nub340/Tesla-Front-Drive-Unit/tesla_sdu_controller_connections.png

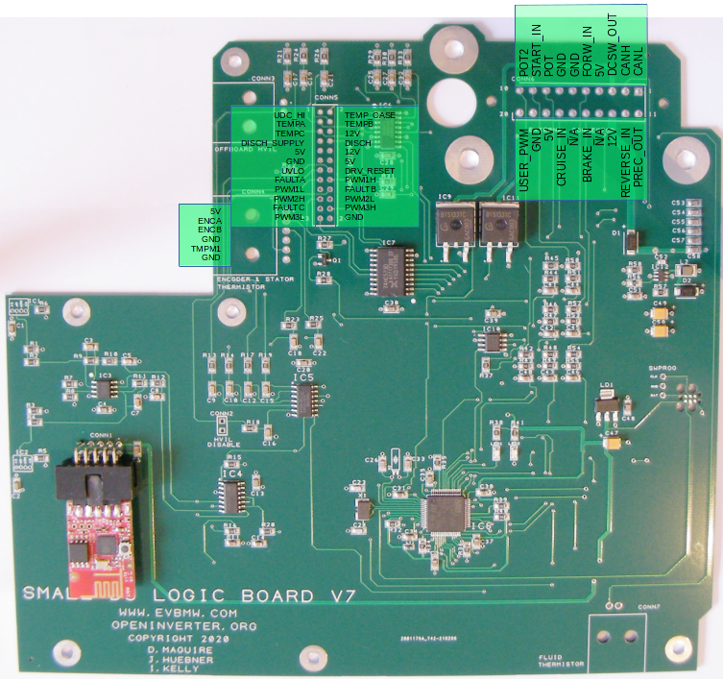
tesla_sdu_controller_connections.png
