nub340/Tesla-Front-Drive-Unit/V7/Tesla_FDU_V7_BOM_JLC_2.xls

Comment | Designator | Footprint | LCSC Part #
74HCT4052D | IC6 | SOIC-16_3.9x9.9x1.27P | C87281
BTS133TC | IC9,IC11 | TO-263-2 | C2681318 | C152447
0.1uF | C1,C2,C4,C13,C20,C28,C30,C35,C39,C53,C52 | 0805_C | C49678
1nF | C5,C8,C18,C22,C29 | 0805_C | C46653
1uF | C11,C14,C17,C19,C21,C25,C27,C31,C32,C36,C37,C38,C40,C41,C42,C43,C44,C45,C46,C51 | 0805_C | C28323
10nF | C9,C10,C12,C15,C16, | 0805_C | C1710
22PF | C23,C24 | 0805_C | C1804
50pF | C3,C7 | 0805_C | C1716
CD74HC30M | IC5 | SOIC-14_3.9x8.7x1.27P | C6540
10pF | C26,C33 | C_0805 | C1785
10uF | C6,C34,C48,C54,C55,C56,C57,C58 | 0805_C | C40894
AMS1117-3.3 | LD1 | SOT-223 | C6186
RED LEDS | LED1,LED2 | CHIPLED_0805 | C84256
SCT2401TVBR | IC12 | TSOT-23-6 | C2830166
LM2901DT | IC4 | SOIC-14_3.9x8.7x1.27P | C142961
10uH | L1 | 0603 | C1035
MC74HCT573ADWR2G | IC7 | SOIC-20_7.5x12.8x1.27P | C5608
LM2904DR2G | IC3 | SOIC-8_3.9x4.9x1.27P | C18229
MMBT3904 | Q1 | SOT-23-3 | C20526
1KΩ | R23,R28,R32,R34,R38,R39,R40 | 0805_R | C17513
1.5KΩ | R43,R47,R49,R53,R55 | 0805_R | C4310
3.3KΩ | R10,R12,R31 | 0805_R | C26010
3.16KΩ | R7 | 0805_R | C52603
4.7KΩ | R8,R36,R42,R46,R48,R52,R54 | 0805_R | C23162
10KΩ | R1,R3,R5,R6,R15,R16,R20,R22,R25,R35,R44,R45,R50,R51,R58 | 0805_R | C17414
62KΩ | R9,R11 | 0805_R | C17783
100KΩ | R2,R4,R57 | 0603_R | C25803
100Ω | R27 | 0805_R | C17408
120Ω | R37 | 0805_R | C17437
150kΩ | R21,R24,R26,R30,R33 | 0805_R | C17470
470Ω | R41 | 0805_R | C17710
470kΩ | R29 | 0805_R | C17709
560Ω | R13,R14,R17,R18,R19 | 0805_R | C28636
SN65HVD230 | IC10 | SOIC-8_3.9x4.9x1.27P | C12084
SS54 | D1,D2 | SMA,DO-214AC | C22452
STM32F103RBT6 | IC8 | LQFP-64_10.0x10.0x0.5P | C8735
4.7UH | L2 | 1210 | C90319
100UF 6.3V | C50,C49,C47 | CASE-B_3528 | C16133
8MHz | X1 | SMD-5032_2P | C115962
51kΩ | R56 | 0805_R | C23196
