nub340/Tesla-Front-Drive-Unit/V9/Tesla_FDU_V9 - Schematic.pdf

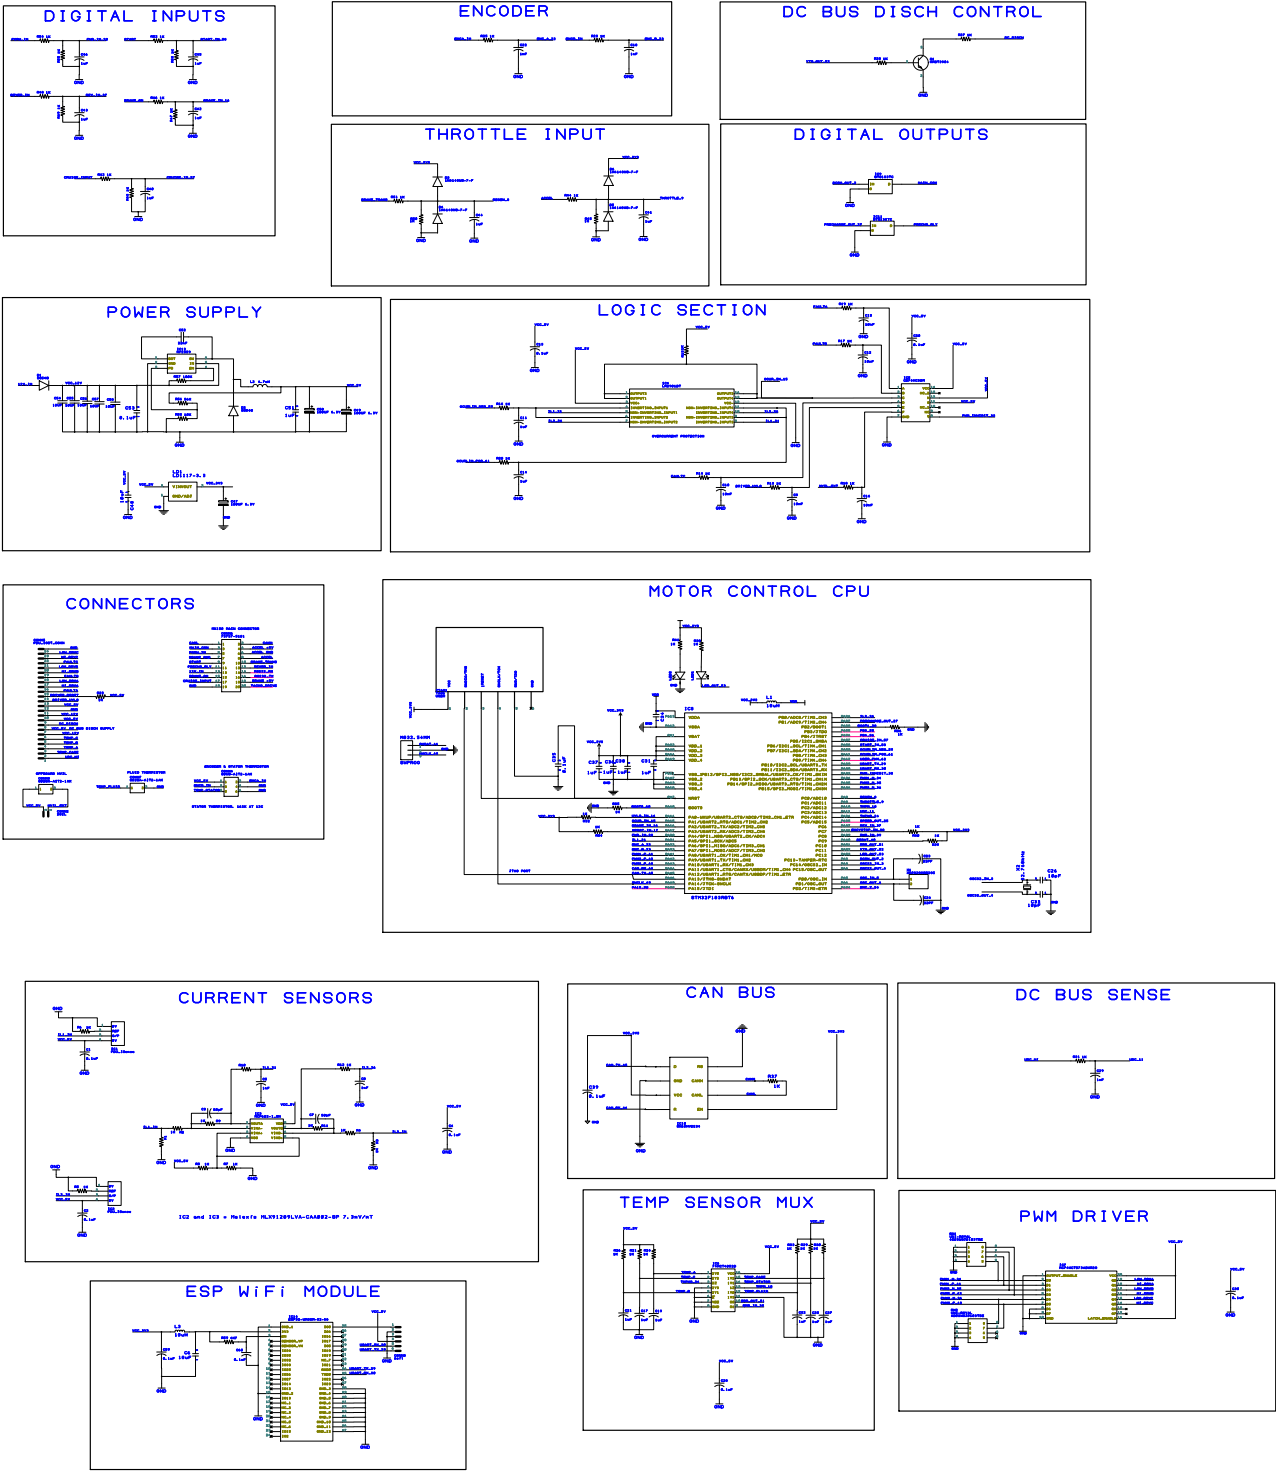
[picture p2: page 1]
