nub340/Tesla-Front-Drive-Unit/V9/Tesla_FDU_V9 - PCB.pdf

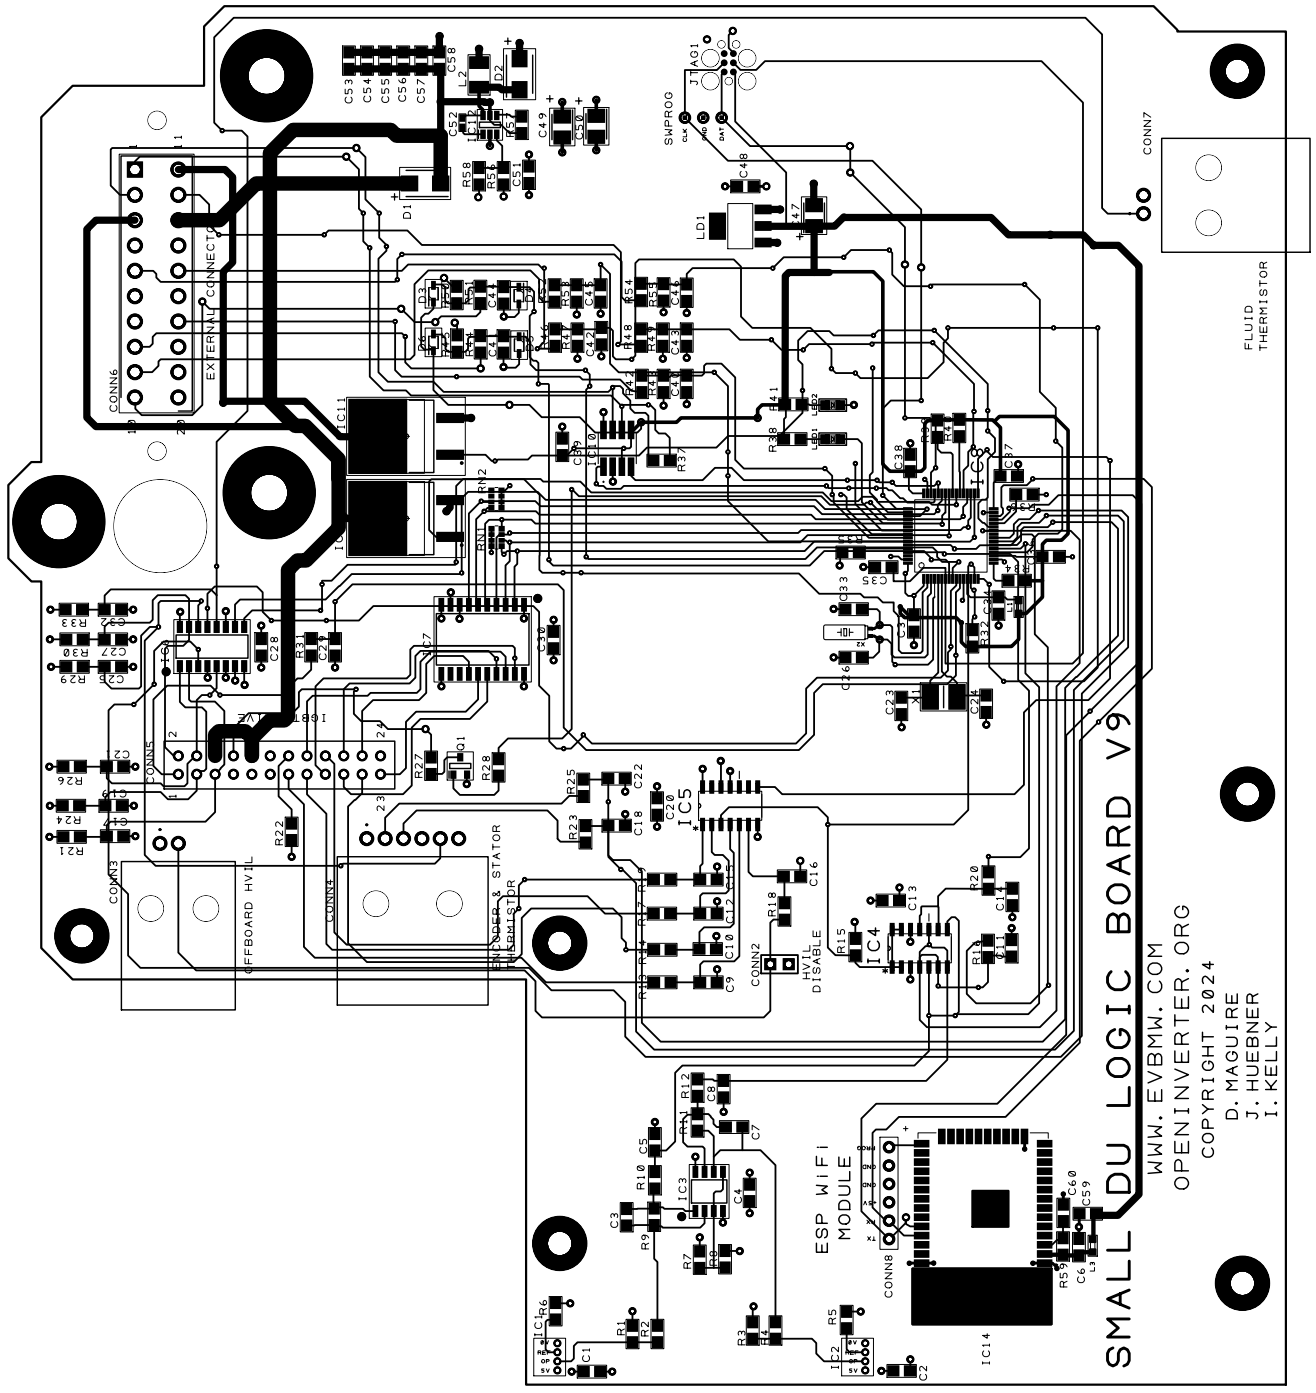
[picture p3: page 1]
