nub340/Tesla-Front-Drive-Unit/V8/Tesla_FDU_V8 - Schematic.pdf

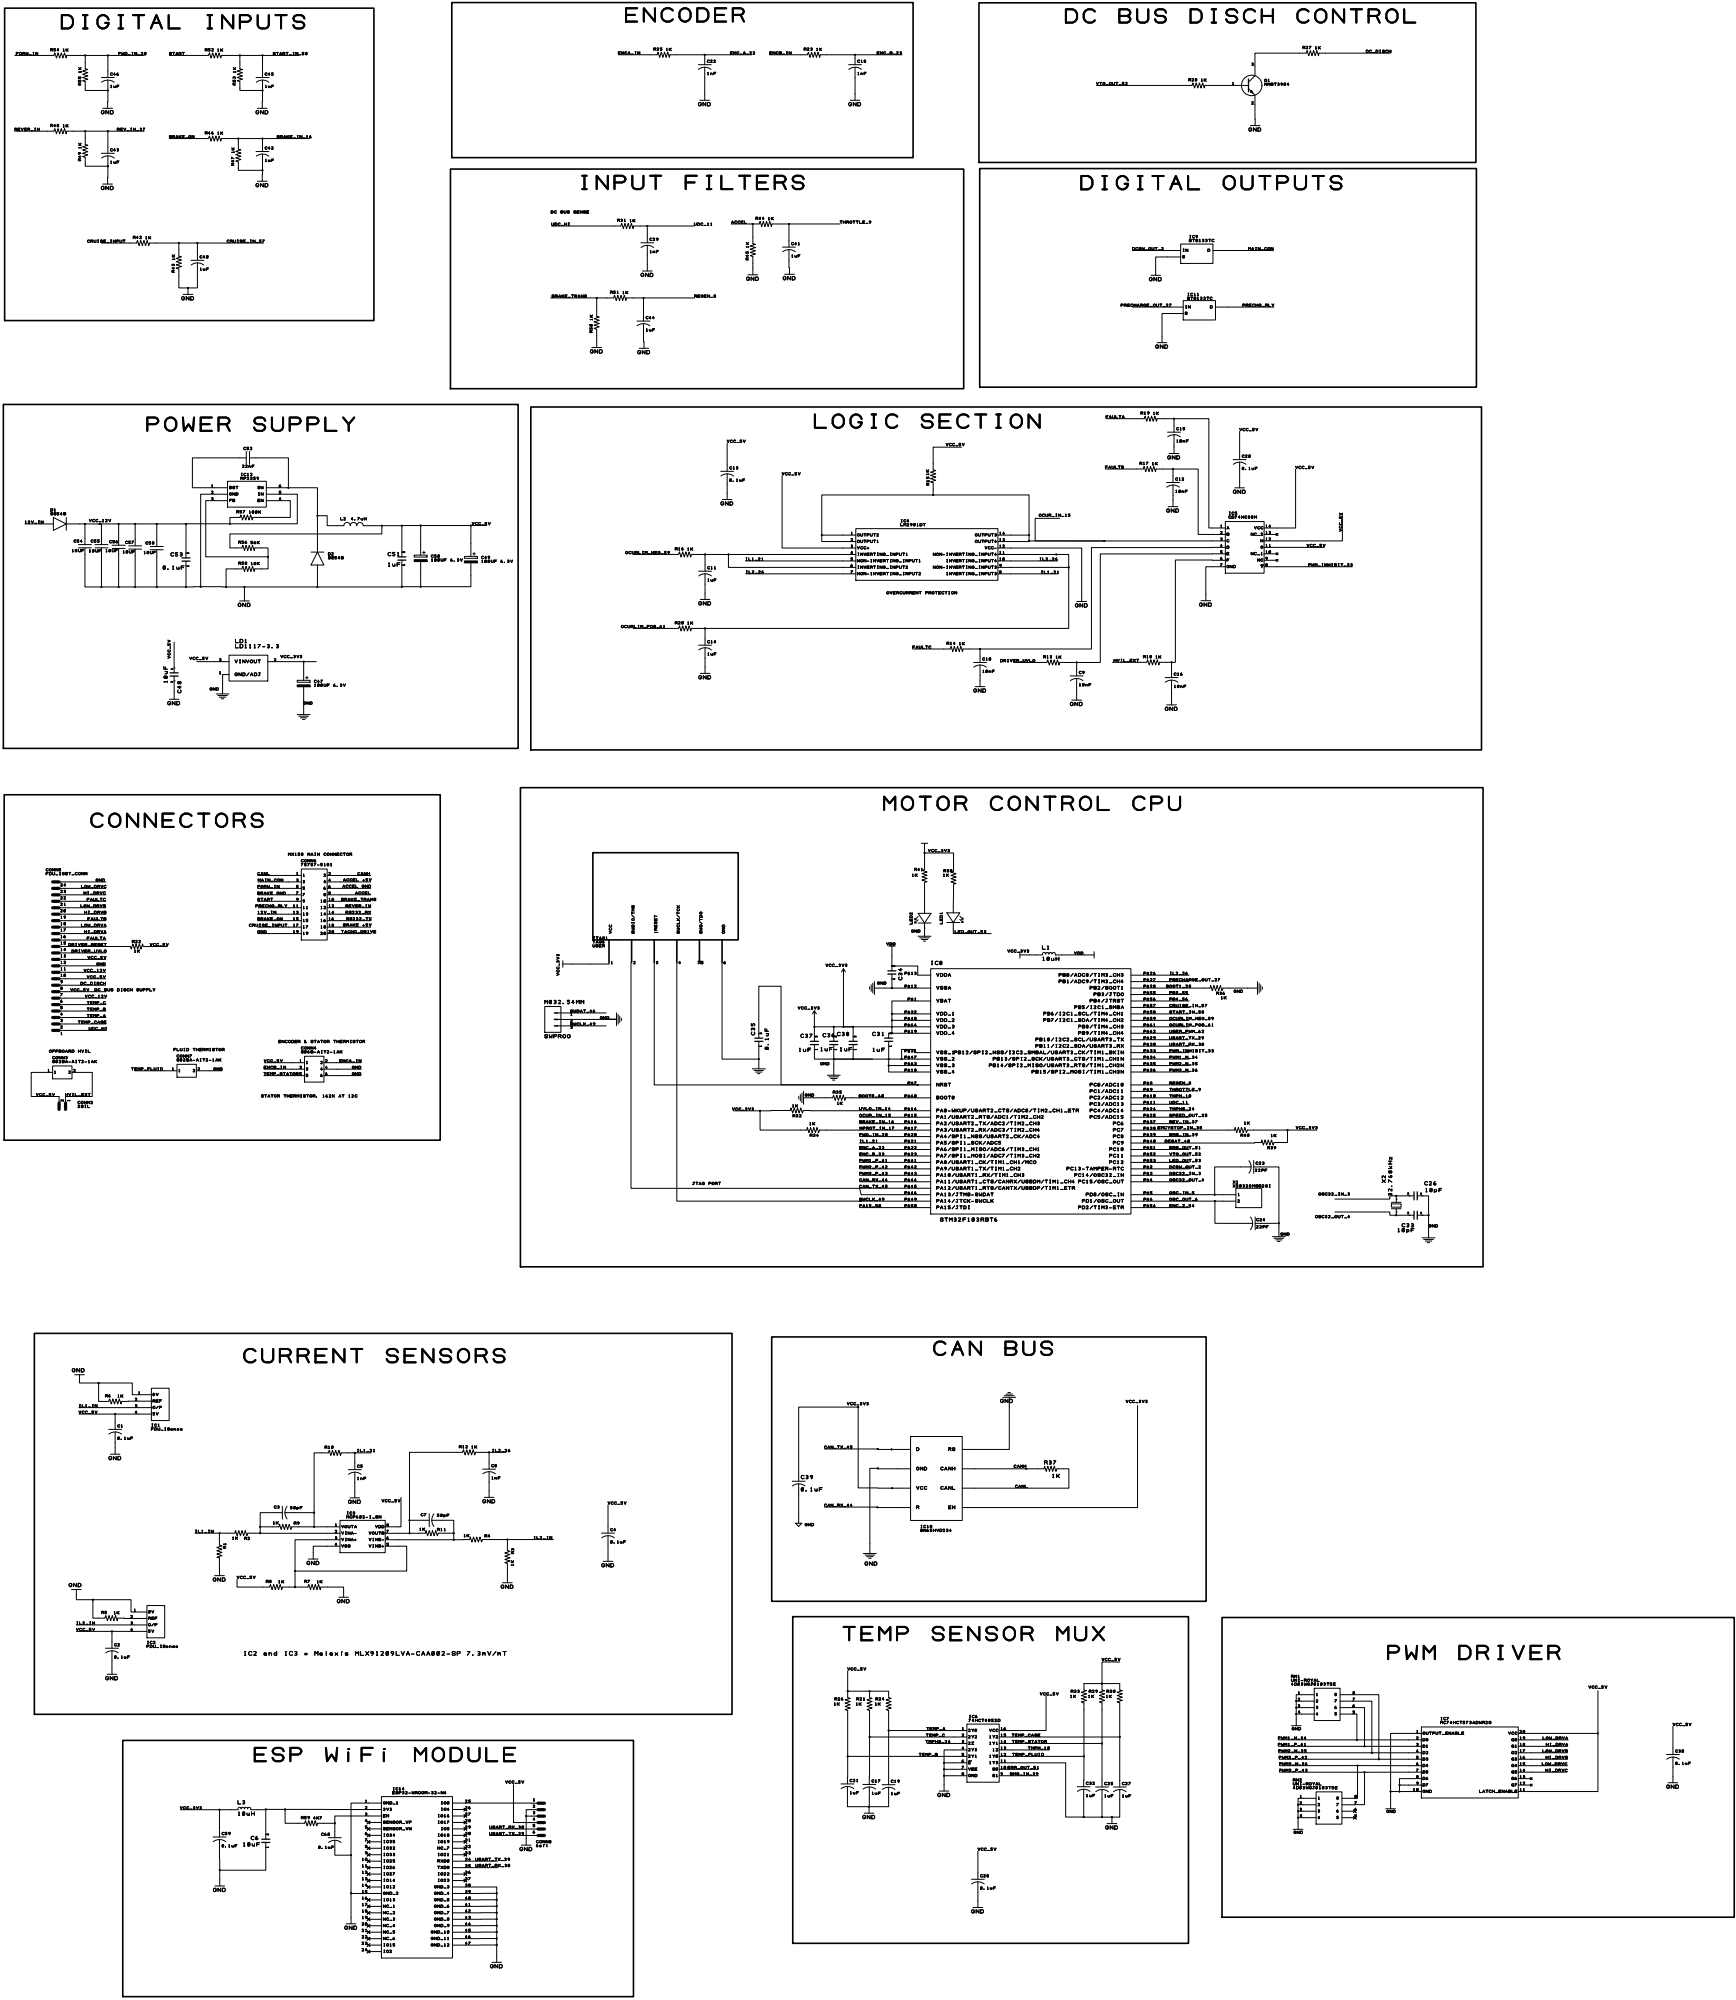
[picture p4: page 1]
