nub340/Tesla-Front-Drive-Unit/(list of files, drawings)

Other design files:
V7/Tesla_FDU_V7.pcb
V8/Tesla_FDU_V8.pcb
V9/Tesla_FDU_V9.pcb
