nub340/Tesla-Front-Drive-Unit/(commit log)

2021-04-08 Version V7 with new 5V regulator
    [Tesla_FDU_V6_BOM_JLC.xls, Tesla_FDU_V7.pcb, Tesla_FDU_V7.sch, Tesla_FDU_V7_BOM_JLC_2.xls, params_motor_inverter.json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]
2023-02-14 V8 with ESP32 wifi on board
    [Tesla_FDU_V8.pcb, Tesla_FDU_V8.sch, Tesla_FDU_V8_BOM_JLC.xls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]
2023-03-05 Corrected TAG connect
    [Tesla_FDU_V7_BOM_JLC_2.xls, Tesla_FDU_V8.pcb, Tesla_FDU_V8.sch]
2023-04-24 bom field name
2025-02-20 V9 with throttle voltage divider
    [Tesla_FDU_V9.pcb, Tesla_FDU_V9.sch]
